adwiens-hardware/arduino-inverter-power-saver/(commit log)

2020-07-22 Add new circuit that removes temp. sensor and instead senses AC current to fridge
2020-07-24 Add photo of completed circuit
2020-07-30 Add photo of inverter wires
